Tejasgarg/pslab-mini-hardware/schematic/3DModels/USB_C.stp

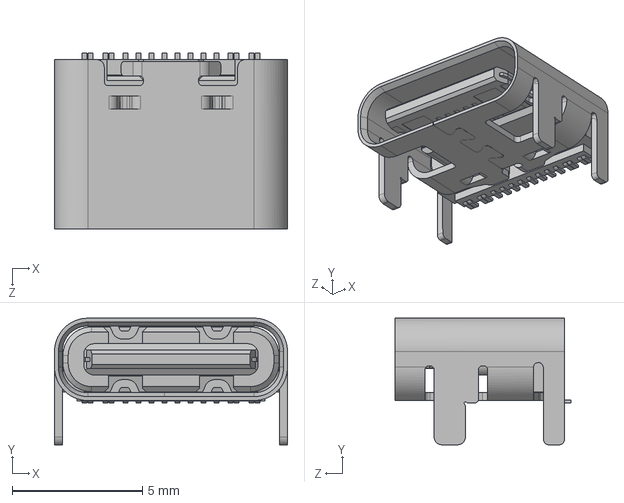
[picture p1: CAD file, 2025-08-13]
schematic/3DModels/USB_C.stp
8.94 x 4.86 x 6.75 mm
