Tejasgarg/pslab-mini-hardware/schematic/3DModels/BNC_Connector.stp

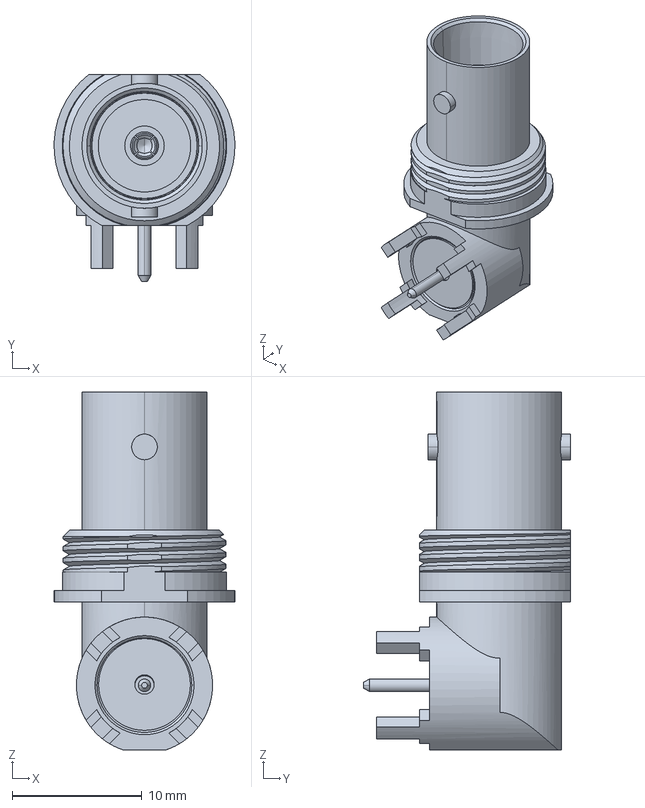
[picture p2: CAD file, 2025-08-13]
schematic/3DModels/BNC_Connector.stp
14.0 x 16.0 x 27.6 mm
