Tejasgarg/pslab-mini-hardware/schematic/3DModels/Battery_connector.stp

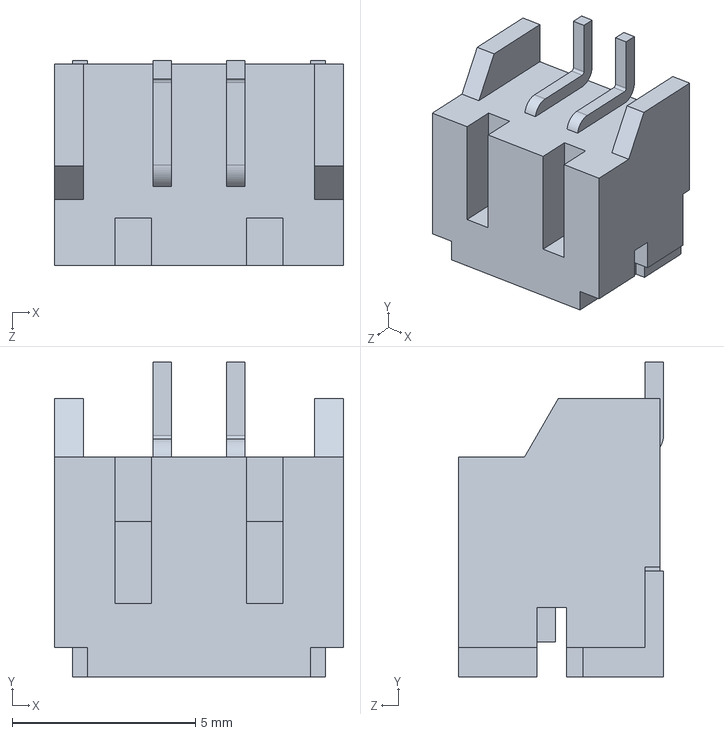
[picture p3: CAD file, 2025-08-13]
schematic/3DModels/Battery_connector.stp
7.90 x 8.60 x 5.60 mm
