Tejasgarg/pslab-mini-hardware/(commit log)

2025-07-28 added oscilloscope components
    [pslab-mini.kicad_sch]
2025-08-04 Adding basic layouting and floorplan for PSLab Mini Board
    [pslab-mini.kicad_pcb, pslab-mini.kicad_sch]
2025-08-07 Footprint updates
2025-08-07 Naming reconfiguration and removing the BOOT0 button
    [pslab-mini.kicad_sch]
2025-08-08 Adding PCB Floorplan
    [pslab-mini.kicad_pcb]
2025-08-08 Adding major components to the layout
    [pslab-mini.kicad_pcb]
2025-08-10 Completed layout
    [pslab-mini.kicad_pcb, pslab-mini.kicad_sch]
2025-08-11 sch and pro
    [pslab-mini.kicad_sch]
2025-08-11 new layout
    [pslab-mini.kicad_pcb, pslab-mini.kicad_sch]
2025-08-11 new routing
    [pslab-mini.kicad_pcb, pslab-mini.kicad_sch]
2025-08-13 Project and schematic changes
    [pslab-mini.kicad_sch]
2025-08-13 Footprint and 3D Model updates
    [BNC_Connector.stp, Battery_connector.stp, USB_C.stp]
2025-08-13 PCB optimization and update
    [pslab-mini.kicad_pcb]
2025-08-16 Adding MC34063ADR
    [pslab-mini.kicad_sch]
2025-08-26 Differential routing for USB
    [pslab-mini.kicad_pcb]
2025-09-05 op-amp update
    [pslab-mini.kicad_sch]
2025-10-01 updated vias
    [pslab-mini.kicad_pcb]
2025-10-02 adding output files
    [JLCPCB_SMT_BOM.csv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]
